QIQ1Fan/haixing/Core/Inc/bsp_config.h

/**
  ******************************************************************************
  * @file    bsp_config.h
  * @brief   ★ 工程总入口：硬件资源分配 + 所有可调参数
  *
  * ============================================================================
  *  一、这个工程是什么
  * ============================================================================
  *  基于 STM32F103C8T6 的八路循迹小车。功能组成：
  *    · 循迹行驶     八路探头 → 位置误差 → 转向环 PID → 左右轮差速
  *    · 闭环测速     双路编码器（可选速度环 / 里程统计 / 状态显示）
  *    · 人机交互     OLED 调参菜单 + 四按键，参数可掉电保存到 Flash
  *    · 支撑脚舵机   舵机推支撑脚，把车撑起 / 收起（自动逻辑留待后续）
  *    · 调试         串口自检菜单 + 实时状态打印
  *
  * ============================================================================
  *  二、外设怎么分（一个外设只干一件事，互不打架）
  * ============================================================================
  *  定时器类：
  *    TIM3  CH1  PA6         左电机 PWM                   20kHz  硬件 PWM
  *    TIM3  CH2  PA7         右电机 PWM                   20kHz  硬件 PWM
  *    TIM2  CH1/2 PA0/PA1    左编码器 A/B 相（硬件四倍频） 不计频
  *    TIM4  CH1/2 PB6/PB7    右编码器 A/B 相（硬件四倍频） 不计频
  *    TIM1  （无输出引脚）    支撑脚舵机软件 PWM 的时基     1MHz   ★ 见下方说明
  *    SysTick                主循环 10ms 节拍 + HAL_Delay
  *
  *  串口类：
  *    USART1     PA9/PA10    调试打印 / 蓝牙模块           115200-8-N-1
  *
  *  纯 GPIO 类：
  *    PB0  PB1     TB6612 AIN1/AIN2   左电机方向
  *    PB10 PB11    TB6612 BIN1/BIN2   右电机方向
  *    PA4          TB6612 STBY        高=工作 低=待机
  *    PB4          支撑脚舵机信号      ★ 软件 PWM，见下方说明
  *    PA2 PA3 PA5 PA8 PA11 PA12 PB5 PB12   八路循迹（内部上拉输入）
  *    PB13 PB14 PB15 PA15                  四按键：确认/退出/加/减
  *    PB3          蜂鸣器（低电平触发）
  *    PB8 PB9      OLED 软件 I2C（SCL/SDA）
  *    PA13 PA14    SWD 调试口（不能动）
  *
  *  ★★ JTAG 引脚释放（PA15 / PB3 / PB4 都靠它）★★
  *    这三个脚默认是 JTAG 的 JTDI / JTDO / NJTRST，不是普通 GPIO。
  *    CubeMX 已在 HAL_MspInit() 里调用 __HAL_AFIO_REMAP_SWJ_NOJTAG()：
  *    它把 SWJ_CFG 设成 010（JTAG-DP 关闭、SW-DP 保留），于是
  *    PA15、PB3、PB4 全部变成普通 GPIO，同时 PA13/PA14 的 SWD 下载不受影响。
  *    删掉那行，本工程就会有三个引脚静默失效（按键的"减"、蜂鸣器、舵机）。
  *
  *  ★★ 为什么舵机是软件 PWM 而不是硬件 PWM ★★
  *    PB4 上唯一可用的定时器输出是 TIM3_CH1（部分重映射）。但 TIM3 已经
  *    被电机 PWM 占用了，而 TIM3 的重映射是"整组生效"的 —— 一旦重映射，
  *    CH1/CH2 会从 PA6/PA7 一起搬到 PB4/PB5，电机就没波形了，而且 PB5
  *    还被循迹占用。TIM1/TIM2/TIM4 的通道都不在 PB4 上。
  *    （TIM3 完全重映射的目标 PC6~PC9 在 LQFP48 封装上没有引出。）
  *
  *    所以改用 TIM1 做纯时基 + 中断里翻转 PB4：每 20ms 两次中断，
  *    合计 100 次/秒，CPU 开销可以忽略。代价是脉冲边沿有几十微秒的
  *    软件抖动，普通舵机会有轻微嗡嗡声。
  *
  * ============================================================================
  *  三、软件分层（谁调用谁）
  * ============================================================================
  *
  *   应用层  app_*        ┌──────────────┐
  *   （小车业务）         │   app_menu   │  OLED 调参界面 + 四按键
  *                        └──────┬───────┘
  *                               │ 改参数 / 启停
  *                               ▼
  *                        ┌──────────────┐   ┌──────────────┐
  *                        │   app_car    │──►│   app_leg    │ 支撑脚舵机
  *                        │  循迹控制律  │   └──────┬───────┘
  *                        └──┬────────┬──┘          │
  *                           │        │             │
  *   驱动层  bsp_*           ▼        ▼             ▼
  *                     ┌─────────┐ ┌────────┐  ┌──────────┐
  *                     │bsp_motor│ │bsp_pid │  │bsp_servo │
  *                     └────┬────┘ └────────┘  └────┬─────┘
  *                          │                       │
  *              ┌───────────┼───────────┬───────────┘
  *              ▼           ▼           ▼
  *        ┌──────────┐ ┌──────────┐ ┌──────────┐
  *        │bsp_track │ │bsp_encod.│ │bsp_gpio  │
  *        └──────────┘ └──────────┘ └────┬─────┘
  *                                       │
  *              ┌────────┬────────┬──────┴───┬──────────┐
  *              ▼        ▼        ▼          ▼          ▼
  *          bsp_key  bsp_oled  bsp_uart  bsp_buzzer  app_param
  *                                                        （Flash 参数）
  *
  *    参数总线：app_param 里的 g_param 是"所有可调参数的唯一存放处"。
  *    app_menu 负责改它，app_car / app_leg 每个控制周期读它 ——
  *    所以调参是"立即生效"的，不需要任何跨模块通知机制。
  *
  * ============================================================================
  *  四、初始化顺序（main.c 里按此顺序调用）
  * ============================================================================
  *   UART → GPIO → Buzzer → Key → Track → Encoder → Servo → Motor → OLED
  *        → Param → Leg → Car → Menu
  *   · UART 最先：后面任何模块出问题，报错才打得出来
  *   · Motor 靠后且 STBY 最后使能：避免上电瞬间电机乱冲
  *   · OLED 靠后：它自带 100ms 上电等待，不拖累前面的模块
  *   · Param 必须在 Leg / Car 之前：它们要读参数决定初始姿态
  *
  * ============================================================================
  *  五、怎么用
  * ============================================================================
  *   1. 硬件对不上时，只改本文件里的宏，别的地方不用动
  *   2. 需要改"默认手感"（PID、速度、丢线策略）时改 app_param.c 的默认值表，
  *      或者直接在 OLED 菜单里调完按"保存"，掉电不丢
  *   3. Keil 编译下载，串口 115200 打开，按 1~9 逐项验硬件
  *   4. 底层全绿后，OLED 菜单选 "START" 就能跑车
  *
  * ============================================================================
  *  六、时钟前提（CubeMX 已配好，这里只是说明为什么下面的公式成立）
  * ============================================================================
  *   HSE 8MHz → PLL×9 → SYSCLK = 72MHz
  *   AHB  = 72MHz
  *   APB1 = 36MHz（HCLK 分频 2）→ 挂在 APB1 上的 TIM2/TIM3/TIM4 时钟 = 72MHz
  *   APB2 = 72MHz                → 挂在 APB2 上的 TIM1 时钟      = 72MHz
  *
  *   ★ 关键点：APB1 分频系数只要不等于 1，STM32 会自动把该总线上
  *     定时器的时钟再乘 2。所以 TIM2/TIM3/TIM4 虽然挂在 36MHz 的 APB1 上，
  *     实际计数时钟仍是 72MHz。算 PWM 频率时要用 72MHz，不是 36MHz。
  ******************************************************************************
  */
#ifndef __BSP_CONFIG_H
#define __BSP_CONFIG_H

#ifdef __cplusplus
extern "C" {
#endif

#include "stm32f1xx_hal.h"

/* ==========================================================================
 * 1. 支撑脚舵机 —— PB4 / 软件 PWM / 50Hz
 * --------------------------------------------------------------------------
 * 数据流： APP_Leg_SetAngle(角度) → BSP_Servo_SetAngle → 换算成脉宽 s_pulse_us
 *            → TIM1 中断每 20ms 翻转两次 PB4
 *              （周期开始拉高，过了脉宽时间拉低）
 *            → 舵机比较脉宽 → 转到对应角度 → 推/收支撑脚
 *
 * 为什么是 50Hz：舵机（航模舵机）的标准控制协议就是每 20ms 收到一个脉冲，
 * 脉冲高电平 0.5~2.5ms 对应左右两个极限位置。频率不对舵机会抖或不响应。
 *
 * ★ 本工程里舵机不用于转向 —— 转向靠左右轮差速（详见第 9 节）。
 *   舵机只负责支撑脚：放下（撑起车身）/ 收起（行驶位）。
 *   具体角度不写死在这里，而是作为可调参数放在 app_param 里，
 *   因为支撑脚的机械行程必须实车标定，菜单里改完能直接存 Flash。
 * ========================================================================== */
#define SERVO_GPIO_PORT             GPIOB
#define SERVO_GPIO_PIN              GPIO_PIN_4

/* 软件 PWM 的时基定时器。★ 它一个输出引脚都不占，只提供"1 微秒走一格"的
   计时和每周期一次的更新中断。所以换成别的定时器也不影响接线。 */
#define SERVO_TIM                   TIM1
/* 72MHz / (71+1) = 1MHz，即 1 个计数 = 1 微秒。
   这样中断里算时间不需要任何换算，读到的计数就是微秒数 */
#define SERVO_TIM_PSC               (72u - 1u)
/* 周期 20000 微秒 = 20ms = 50Hz */
#define SERVO_PWM_PERIOD_US         20000u
/* TIM1 的更新中断优先级。比 SysTick(15) 高，保证脉冲边沿不被主循环拖慢 */
#define SERVO_IRQ_PRIORITY          1u

/* 舵机的机械行程标定。
 * ★ 本工程的舵机规格：500~2500us 对应 0°~180°，中位 90° = 1500us。
 *   如果你的舵机是 1000~2000us 那种小舵机，把下面两个 US 值改掉即可，
 *   角度范围不用动（换算公式会自动按比例适配）。 */
#define SERVO_PULSE_MIN_US          500u    /* 对应 0°   */
#define SERVO_PULSE_MAX_US          2500u   /* 对应 180° */
#define SERVO_PULSE_MID_US          1500u   /* 对应 90°  */
#define SERVO_ANGLE_MIN             0
#define SERVO_ANGLE_MAX             180
#define SERVO_ANGLE_MID             90

/* ==========================================================================
 * 2. 电机 —— TIM3_CH1/CH2 / PA6 / PA7 / 20kHz
 * --------------------------------------------------------------------------
 * 数据流： BSP_Motor_SetSpeed(带符号速度)
 *            ├─ 符号位 → 决定 AIN1/AIN2 电平组合 → TB6612 输出极性
 *            └─ 绝对值 → 写进 CCR → 决定 PWM 占空比 → TB6612 输出电压
 *
 * 为什么是 20kHz：超过人耳听觉上限电机就不发出刺耳啸叫；低于 16kHz
 * 能听到尖锐噪音。20kHz 是"噪音"与"MOS 开关损耗"之间的常用折中。
 * ========================================================================== */
#define MOTOR_TIM                   TIM3
#define MOTOR_CH_L                  TIM_CHANNEL_1   /* PA6 */
#define MOTOR_CH_R                  TIM_CHANNEL_2   /* PA7 */
#define MOTOR_GPIO_PORT             GPIOA
#define MOTOR_GPIO_PIN_L            GPIO_PIN_6
#define MOTOR_GPIO_PIN_R            GPIO_PIN_7

/* PSC=0 → 计数时钟就是 72MHz；ARR=3599 → 72MHz/3600 = 20kHz。
 * 占空比分辨率 = 1/3600 ≈ 0.028%。若图省事取 PSC=71（1MHz 计数），
 * ARR 只剩 999，分辨率掉到 0.1%，低速时能看出明显台阶感。 */
#define MOTOR_TIM_PSC               (0u)
#define MOTOR_TIM_ARR               (3600u - 1u)
#define MOTOR_PWM_MAX               (MOTOR_TIM_ARR)     /* 满占空比对应值 */

/* TB6612 方向引脚 + 使能 */
#define MOTOR_DIR_PORT              GPIOB
#define MOTOR_AIN1_PIN              GPIO_PIN_0
#define MOTOR_AIN2_PIN              GPIO_PIN_1
#define MOTOR_BIN1_PIN              GPIO_PIN_10
#define MOTOR_BIN2_PIN              GPIO_PIN_11
#define MOTOR_STBY_PORT             GPIOA
#define MOTOR_STBY_PIN              GPIO_PIN_4

/* ==========================================================================
 * 电机转向取反 —— 出厂默认值（纠正"电机正负极接反"）
 * --------------------------------------------------------------------------
 * ★ 这两个宏现在只是【默认值】：它们决定 APP_Param 里 MLINV / MRINV 的出厂值，
 *   而真正起作用的是那份参数（见 app_param.c）。所以：
 *     · 在这里改 + 重编 —— 适合"一次定下来，以后不用管"
 *     · 在 OLED 菜单 TUNE PARAMS 里改 MLINV / MRINV —— 适合现场试，
 *       改完立刻生效，不用重编重烧
 *   两条路都通，值不会打架（菜单里改的就是这个默认值的副本）。
 *
 * 【为什么现在是 L=1、R=0】
 *   更换电机之后，由于接线问题，整台车的"前进"变成了"后退" ——
 *   也就是说【两个电机的极性相对之前的配置整体翻了一次】。
 *
 *   要纠正"整体翻一次"，就把这两个开关【同时取反】：
 *       原来 L=0 / R=1   →   现在 L=1 / R=0
 *   ★ 注意是"两个都取反"，不是"两个都写 1"：
 *     两个都写 1 只是在原来的基础上再翻一次，结果是车往后走。
 *   ★ 同时取反之后，不只是前后方向恢复，左右转向也跟着恢复 ——
 *     因为软件取反和硬件接反正好互相抵消，命令到轮子的映射回到了原样。
 *
 * 【怎么复核】
 *   把车架空（轮子离地）敲测试 4，前进段两个轮子都该朝车头方向转。
 *     · 复验通过            → 就这样，不用再动
 *     · 有一个轮子反了       → 只把那一个的开关取反（车会原地打转就是这种）
 *     · 两轮都往后走         → 这次是"两个都写 1"（即两个都再翻一次）
 *
 * 【⚠ 换电机/重新接线之后，除了这两个开关，还要复核 STEERINV】
 *   如果接线时把左右两个电机的位置也对调了，那么"左右分配"也翻了，
 *   STEERINV 要跟着改回 0，否则车会往远离线的方向拐。
 *   判断方法：车放线上、故意让线偏在左边，启动后车应该朝【左】拐。
 *
 * 【它管什么、不管什么】
 *   只管"电机正转的方向对不对"，不管"左右轮有没有装反"。
 *   两个轮子都往前转、也能走直线，但上了线越纠越偏 —— 那是 STEERINV 的事。 */
#define MOTOR_L_INVERT              1
#define MOTOR_R_INVERT              0

/* ==========================================================================
 * 3. 编码器 —— TIM2(PA0/PA1) / TIM4(PB6/PB7)   硬件编码器模式
 * --------------------------------------------------------------------------
 * 数据流： 电机转 → 编码器出 A/B 两相方波 → 定时器硬件四倍频自动计数（不耗 CPU）
 *          → bsp_encoder 每 10ms 读一次计数差
 *            → 按"实际经过的毫秒数"算转速（抗主循环抖动，见第 9 节说明）
 *
 * 为什么用定时器的编码器模式而不是外部中断：四倍频后脉冲频率很高
 * （减速比 30 时每转上千个计数），用中断会吃掉大量 CPU；硬件模式下
 * 计数完全由定时器外设完成，CPU 只负责周期性读一次数值。
 * ========================================================================== */
#define ENC_L_TIM                   TIM2
#define ENC_R_TIM                   TIM4
#define ENC_GPIO_PORT_L             GPIOA
#define ENC_GPIO_PIN_LA             GPIO_PIN_0      /* TIM2_CH1 */
#define ENC_GPIO_PIN_LB             GPIO_PIN_1      /* TIM2_CH2 */
#define ENC_GPIO_PORT_R             GPIOB
#define ENC_GPIO_PIN_RA             GPIO_PIN_6      /* TIM4_CH1 */
#define ENC_GPIO_PIN_RB             GPIO_PIN_7      /* TIM4_CH2 */

/* ★ STM32F103 的 TIM2~TIM5 全是 16 位计数器（只有 F4/F7 的 TIM2/TIM5 是 32 位），
 *   计数到 65535 会回绕。bsp_encoder 用 (int16_t)(now - last) 处理回绕，
 *   前提是单个采样周期内位移不超过 ±32767 个计数。 */
#define ENC_TIM_IS_16BIT            1

/* --- 测速标定：换电机/换编码器/换轮子都要改这里 --- */
#define ENC_PPR                     13.0f   /* 编码器每转脉冲数（单相） */
#define ENC_MULT                    4.0f    /* 四倍频：A/B 两相各上下沿都计数 */
#define ENC_GEAR_RATIO              30.0f   /* 减速箱减速比 */
/* 输出轴（轮子）转一圈的总计数。转速公式的分母就是它 */
#define ENC_CPR                     (ENC_PPR * ENC_MULT * ENC_GEAR_RATIO)

/* 测速采样周期（名义值）。bsp_encoder 内部按 HAL_GetTick() 实测的间隔
 * 换算转速，这个宏只在"实测间隔不合理"时作为兜底值使用 */
#define ENC_SAMPLE_PERIOD_MS        10u

/* 单次采样间隔的合法范围（毫秒）。
 *   下限 1ms：两次调用挤在同一毫秒内时，用 1ms 兜底，杜绝除零。
 *   上限 1000ms：主循环被阻塞超过 1 秒（串口自检、断点、卡死）时，
 *   这一段增量已经不能代表"当前转速"了，直接丢弃，不报假数据。
 *
 * ★ 注意这里不是"必须 10ms"：bsp_encoder 用的是实测间隔，
 *   所以主循环偶尔被 OLED 刷屏拖到 30ms 也不会算错转速。
 *   这正是它和"写死 10ms"的关键区别。 */
#define ENC_DT_MIN_MS               1u
#define ENC_DT_MAX_MS               1000u

/* 编码器输入滤波系数 0..15（0=不滤波）。电机碳刷噪声大，建议 8~12。
 * 出现"高速丢计数"就往下调；出现"轮子没动计数却在跳"就往上调。 */
#define ENC_IC_FILTER               10u

/* 编码器方向反了（比如差速时左右轮读数符号相反）置 1 */
#define ENC_L_INVERT                0
#define ENC_R_INVERT                0

/* 轮子直径（mm），用来把转速换算成线速度 mm/s。
 * 只影响显示和串口打印，不影响控制。用卡尺量含橡胶胎面的外径 */
#define ENC_WHEEL_DIA_MM            65.0f

/* ==========================================================================
 * 4. 八路循迹 —— GPIO 上拉输入
 * --------------------------------------------------------------------------
 * 数据流： 探头 → 电平 → BSP_Track_GetMask() 位掩码
 *          → 加权求和 → BSP_Track_GetError() 位置误差 → 转向环 PID
 *
 * 索引约定：索引 0..7 默认对应对着车头从左到右。装反了不用改接线，
 * 把下面 TRACK_WEIGHT_0..7 这八个值倒过来写即可。
 * ========================================================================== */
#define TRACK_SENSOR_NUM            8u

/* ★ 这里必须用纯宏 1/0，不能写 GPIO_PIN_RESET：
 *   GPIO_PinState 是 enum 而不是 #define，在 #if 预处理里两个标识符
 *   都会被当成未定义、一律替换成 0，导致条件恒真、分支永远进同一边。
 *   bsp_track.c 里就是用 #if TRACK_ACTIVE_LOW 选分支的。 */
/* ★ 探头极性：压到黑线时引脚是高还是低。1 = 低电平（多数模块），0 = 高电平。
 *
 * 【为什么这里是 0 —— 实车实测推翻了默认值】
 *   把车放好、让黑线正对探头阵列中心，SENSOR CHECK 页读到：
 *       RAW  00111100    → 中间 4 路（2,3,4,5）是高电平，两侧各 2 路是低电平
 *       MASK 11000011    → 老配置说"两侧 4 路压线"
 *   一条居中的黑线只可能压住中间连续的一段探头，绝不可能只压住
 *   最左两路 + 最右两路 —— 那是几何上不可能的图形。
 *   所以真正压到线的是中间那 4 路，而它们读的是【高电平】→ 本模块是高电平有效。
 *
 * ★ 这项现在是运行期参数（app_param 的 ACTLOW），这个宏只是它的出厂默认值。
 *   万一以后换了别的探头模块，在菜单里把 ACTLOW 拨一下就能立刻验证，
 *   不用重编 —— 判断标准见 SENSOR CHECK 页：掩码的 1 必须落在真正压线的那几路上。 */
#define TRACK_ACTIVE_LOW            0

#define TRACK0_PORT                 GPIOA
#define TRACK0_PIN                  GPIO_PIN_2      /* PA2  */
#define TRACK1_PORT                 GPIOA
#define TRACK1_PIN                  GPIO_PIN_3      /* PA3  */
#define TRACK2_PORT                 GPIOA
#define TRACK2_PIN                  GPIO_PIN_5      /* PA5  */
#define TRACK3_PORT                 GPIOA
#define TRACK3_PIN                  GPIO_PIN_8      /* PA8  （原来的舵机脚，已改作循迹）*/
#define TRACK4_PORT                 GPIOA
#define TRACK4_PIN                  GPIO_PIN_11     /* PA11 */
#define TRACK5_PORT                 GPIOA
#define TRACK5_PIN                  GPIO_PIN_12     /* PA12 */
#define TRACK6_PORT                 GPIOB
#define TRACK6_PIN                  GPIO_PIN_5      /* PB5  */
#define TRACK7_PORT                 GPIOB
#define TRACK7_PIN                  GPIO_PIN_12     /* PB12 */

/* 加权位置误差的权重表，索引 0..7 对应传感器 0..7。
 * 计算方式：误差 = Σ(权重 × 该路是否压线) / 压线个数，量程 [-7.0, +7.0]
 *    误差 < 0 → 线在车的左边（车偏右了）→ 需要左转
 *    误差 > 0 → 线在车的右边（车偏左了）→ 需要右转
 *
 * 注意：8 是偶数，探头阵列没有物理中点，所以车正对线时误差会在 ±1
 * 之间跳动而不是稳定的 0，这是正常的，不用去"修"。 */
#define TRACK_WEIGHT_0              (-7.0f)
#define TRACK_WEIGHT_1              (-5.0f)
#define TRACK_WEIGHT_2              (-3.0f)
#define TRACK_WEIGHT_3              (-1.0f)
#define TRACK_WEIGHT_4              ( 1.0f)
#define TRACK_WEIGHT_5              ( 3.0f)
#define TRACK_WEIGHT_6              ( 5.0f)
#define TRACK_WEIGHT_7              ( 7.0f)
/* 误差绝对值上限，用于把误差归一化到 [-1,1] 喂给 PID。
 * 必须等于权重表里绝对值最大的那个，否则归一化会超出 ±1 */
#define TRACK_ERROR_MAX             (7.0f)

/* ==========================================================================
 * 5. 四路按键 —— GPIO 上拉输入，按下读低
 * --------------------------------------------------------------------------
 * 数据流： 引脚电平 → BSP_Key_Scan() 每 10ms 消抖一次
 *          → 短按/长按/连发事件 → app_menu 读走
 *
 * ★ 按键的四个键在本工程里各有一个固定角色（OLED 菜单里印在屏幕底部）：
 *     确认 PB13   进入 / 执行 / 结束编辑
 *     退出 PB14   返回上一级 / 运行中按下 = 急停
 *     加   PB15   选中项上移 / 参数 +
 *     减   PA15   选中项下移 / 参数 -
 * ========================================================================== */
#define KEY_NUM                     4u
/* 按下时的电平。上拉输入 → 按下是低电平。这里只在运行期做比较，用枚举没问题 */
#define KEY_ACTIVE_LEVEL            GPIO_PIN_RESET

/* 四个键的物理位置与固定角色（★ 换引脚只改这四组宏，其它代码一行都不用动）
 *
 *   按键1  PB13   确认 / 进入 / 选定         角色名 KEY_OK
 *   按键2  PB14   取消 / 返回上一级           角色名 KEY_BACK
 *   按键3  PB15   上移（列表）· 加（数值）    角色名 KEY_PLUS
 *   按键4  PA15   下移（列表）· 减（数值）    角色名 KEY_MINUS
 *
 * ★ 代码里全程用 KEY_OK / KEY_BACK / KEY_PLUS / KEY_MINUS 这四个"角色"，
 *   而不是引脚号。所以按键挪到别的脚上时，菜单逻辑一行都不用改 ——
 *   只要保证"物理上那个'加'键"接到 KEY_PLUS 对应的引脚即可。
 *
 * ★ 按键另一端统一接 GND，靠内部上拉，按下读到低电平（见 KEY_ACTIVE_LEVEL）。*/
#define KEY_OK_PORT                 GPIOB
#define KEY_OK_PIN                  GPIO_PIN_13     /* 按键1 确认 */
#define KEY_BACK_PORT               GPIOB
#define KEY_BACK_PIN                GPIO_PIN_14     /* 按键2 取消 */
#define KEY_PLUS_PORT               GPIOB
#define KEY_PLUS_PIN                GPIO_PIN_15     /* 按键3 上移 / 加 */
#define KEY_MINUS_PORT              GPIOA
#define KEY_MINUS_PIN               GPIO_PIN_15     /* 按键4 下移 / 减 */

/* 消抖与长按的时间参数，单位都是"扫描次数"，一次扫描 = KEY_SCAN_PERIOD_MS */
#define KEY_SCAN_PERIOD_MS          10u
#define KEY_DEBOUNCE_CNT            3u      /* 连续 3 次读数一致才认可 = 30ms 消抖 */
#define KEY_LONG_PRESS_CNT          60u     /* 60 × 10ms = 按住 0.6 秒算长按 */
#define KEY_REPEAT_CNT              8u      /* 长按后每 8 × 10ms = 80ms 连发一次 */

/* ==========================================================================
 * 6. 蜂鸣器 —— PB3 / 推挽输出 / 低电平触发
 * --------------------------------------------------------------------------
 * 数据流： BSP_Buzzer_On/Off → PB3 电平 → 蜂鸣器响或不响
 *
 * ★ PB3 是 JTAG 的 JTDO，靠 HAL_MspInit() 里的 SWJ_NOJTAG 释放。
 * ★ 跑车过程中只能用 BeepAsync() + Poll()，绝不能用阻塞的 Beep()：
 *   阻塞 100ms 就等于漏掉 10 拍控制，车会画龙。
 * ========================================================================== */
#define BUZZER_PORT                 GPIOB
#define BUZZER_PIN                  GPIO_PIN_3
/* 低电平触发：响 = RESET，静音 = SET。
 * 如果你的蜂鸣器模块是高电平触发，把这两个值对调即可。 */
#define BUZZER_ON_LEVEL             GPIO_PIN_RESET
#define BUZZER_OFF_LEVEL            GPIO_PIN_SET

/* ==========================================================================
 * 7. OLED —— 软件 I2C / PB8=SCL / PB9=SDA
 * --------------------------------------------------------------------------
 * 数据流： 绘制函数 → 改 1KB 显存 s_buf[] 并标记"这一页脏了"
 *          → BSP_OLED_RefreshDirty() → 只把脏页通过软件 I2C 送出去
 *
 * ★ 为什么要"脏页"机制：
 *   整屏 1024 字节走软件 I2C 大约要 40~50ms，如果每 10ms 就整屏刷一次，
 *   主循环会被吃掉一半，控制节拍全乱。改成"只刷变化的那几页"之后，
 *   状态页一次只送 2~3 页（约 10ms），影响小得多。
 *   BSP_OLED_Refresh()（整屏）仍然保留，开机画面和自检图案用它。
 *
 * ★ 软件 I2C 慢的根因是 i2c_delay() 里的空循环，想更快就调小
 *   OLED_I2C_DELAY_LOOPS。默认 20 很保守（约 100kHz），
 *   调到 5 左右大约能快三倍，代价是长排线时容易花屏。
 * ========================================================================== */
#define OLED_SCL_PORT               GPIOB
#define OLED_SCL_PIN                GPIO_PIN_8
#define OLED_SDA_PORT               GPIOB
#define OLED_SDA_PIN                GPIO_PIN_9
/* SSD1306 的 8 位写地址（7 位地址 0x3C 左移一位）。
 * 如果屏幕全黑但接线没问题，试试改成 0x7A（7 位 0x3D）。 */
#define OLED_I2C_ADDR               0x78u
#define OLED_WIDTH                  128u
#define OLED_HEIGHT                 64u
/* 软件 I2C 的半周期延时（空循环次数）。
 * 屏幕花屏 / 无显示 / 偶发乱码时调这个值：太小则时序过快，太大则刷屏卡顿。 */
#define OLED_I2C_DELAY_LOOPS        20u

/* ==========================================================================
 * 8. 串口调试 —— USART1 / PA9(TX) / PA10(RX) / 115200
 * --------------------------------------------------------------------------
 * 数据流： BSP_UART_Printf() → vsnprintf 格式化 → HAL_UART_Transmit 阻塞发送
 *          接收方向：主循环轮询 BSP_UART_GetChar()，不占用中断
 * ★ 跑车时不要高频打印：115200 下发 1 行 40 字符要 3.5ms，
 *   每拍都打就等于每 10ms 停 3.5ms。bsp_test 里的实时打印都带节流。
 * ========================================================================== */
#define DBG_UART                    USART1
#define DBG_UART_BAUD               115200u
#define DBG_UART_TX_PORT            GPIOA
#define DBG_UART_TX_PIN             GPIO_PIN_9
#define DBG_UART_RX_PORT            GPIOA
#define DBG_UART_RX_PIN             GPIO_PIN_10
/* printf 缓冲区大小。注意它分配在栈上，别超过主栈（CubeMX 配的 0x400 = 1KB） */
#define DBG_PRINTF_BUF_SIZE         128u

/* 是否把 fputc 重定向到串口，让标准 printf() 直接可用。
 *   0 = 默认。只用 BSP_UART_Printf()。功能与 printf 等价，不依赖工具链特性，
 *       不屏蔽半主机（Event Recorder / ITM 仍可用），保证一定能编过。
 *   1 = 额外把 fputc 重定向到 USART1，之后可以直接写 printf()。
 *       代价：屏蔽半主机调试。若链接报 _sys_exit / __use_no_semihosting
 *       相关错误，把它改回 0 即可，BSP_UART_Printf() 不受影响。 */
#define BSP_UART_USE_PRINTF_RETARGET    0

/* ==========================================================================
 * 9. 控制节拍与循迹控制 —— ★ 全工程的时间基准
 * --------------------------------------------------------------------------
 * main.c 里只有一个软节拍器，所有周期性任务都挂在它上面：
 *
 *   每 MAIN_TICK_MS 一次：
 *     BSP_Encoder_Update()   采样编码器（按实测 dt 换算转速）
 *     BSP_Key_Scan()         推进按键状态机
 *     BSP_Buzzer_Poll()      关掉到点的非阻塞鸣叫
 *     APP_Car_Update()       跑一遍循迹控制律（核心）
 *     APP_Leg_Update()       支撑脚缓慢移动
 *     APP_Menu_Update()      按键处理 + 屏幕刷新
 *
 * ★ 下面这四个周期宏必须完全相等，否则转速会成比例偏、按键时间阈值会失准。
 *   与其靠人记住，不如让编译器替我们盯着 —— 不相等直接报错。
 * ========================================================================== */
#define MAIN_TICK_MS                10u     /* 主循环节拍 */
#define CTRL_PERIOD_MS              10u     /* 循迹控制周期 = 控制环的 100Hz */

#if ((MAIN_TICK_MS != CTRL_PERIOD_MS) || \
     (MAIN_TICK_MS != ENC_SAMPLE_PERIOD_MS) || \
     (MAIN_TICK_MS != KEY_SCAN_PERIOD_MS))
#error "MAIN_TICK_MS / CTRL_PERIOD_MS / ENC_SAMPLE_PERIOD_MS / KEY_SCAN_PERIOD_MS 必须全部相等"
#endif

/* 转向环 PID 的采样周期（秒）。喂给 PID 做积分/微分用，必须等于 CTRL_PERIOD_MS */
#define CTRL_DT_S                   ((float)CTRL_PERIOD_MS / 1000.0f)

/* PID 微分项的一阶低通系数（0~1，越小越平滑）。
 * ★ 循迹误差是"8 路开关量加权平均"出来的，天生是阶梯状的，
 *   直接微分会得到一串尖脉冲。加低通之后 D 项才真正可用 */
#define PID_D_FILTER_ALPHA          0.35f

/* ★★ 微分项的限幅比例：D 项单独最多能占输出的百分之多少 ★★
 *
 * 【为什么必须有这一条（这是"边缘探头一读到就往反方向猛打"的直接原因）】
 *   D 项 = KD × (误差变化率)。而误差变化率 = 误差变化量 ÷ 采样周期，
 *   采样周期只有 10ms，所以只要误差跳一格（0.14），变化率就是 14/秒。
 *
 *   探头阵列窄的时候，线扫过阵列只要几十毫秒，误差会从 -1 瞬间跳到 +1：
 *       变化率 = 2.0 / 0.01 = 200/秒
 *       D 项 = KD × 200 = 180 × 200 = 36000
 *   而输出的满量程才 3600 —— D 项早就爆表了，只是被总限幅按住而已。
 *   结果是：**转向输出被 D 项一个人顶到限幅**，P 项完全不起作用，
 *   控制器退化成"一看见误差跳变就往反方向打死"，看起来就是
 *   "边缘探头一读到线，车立刻往反方向甩过去"。
 *
 *   限幅之后 D 项只能贡献一半的输出，剩下的由 P 项决定 ——
 *   D 重新变回"阻尼器"的身份（抑制摆动），而不是"抢方向盘的乘客"。
 *   上限 50% 是经验值：再高就会重新出现甩头，再低则起不到阻尼作用。 */
#define PID_D_LIMIT_RATIO           0.5f

/* 运行中 OLED 的刷新周期。刷屏期间主循环会停住十几毫秒，
 * 所以跑车时不能刷太勤；200ms 一次足够看清数值 */
#define MENU_RUN_REFRESH_MS         200u

/* 停车/待机时 OLED 的刷新周期。调参时人要看着数字变化，快一点 */
#define MENU_IDLE_REFRESH_MS        120u

/* 编码器在本工程里的用途 —— 不做速度闭环，只做"安全与计量"。
 *
 * ★ 为什么不做速度闭环：
 *   循迹环的输出是"左右轮的占空比之差"，它管的是转向；速度闭环管的是
 *   "轮子转多快"。两者串起来要先把占空比标定成转速（每个车都不一样），
 *   参数多一倍、整定难度翻几倍，而在这个速度下收益很小。
 *   所以本工程让编码器干两件立刻见效的事：
 *
 *     1) 堵转检测：占空比给得不小，轮子却一个计数都不动
 *        → 车卡住了 / 编码器线掉了 → 报警停车，保护减速箱
 *     2) 状态显示：OLED 上显示左右轮的实时转速和累计里程
 *
 *   以后真要上速度闭环，把转向环的输出接到一个速度环的目标值上即可，
 *   bsp_pid 是通用的，不用改。
 */
#define CAR_STALL_DUTY_MIN          700     /* 占空比低于这个值就不做堵转判断（起步/低速正常不动） */
#define CAR_STALL_DETECT_MS         1200u   /* 连续这么多毫秒"给电但不转"就报警 */


/* 路线脚本里"数横线"的最小间隔（毫秒）。
 * Route_LineFollowUntilCross(n) 靠"八路全黑"来数路口的横线，
 * 但同一根横线在车压过去的过程中可能黑好几次，所以两根之间至少隔这么久
 * 才算新的一根。太小会把一根数成好几根，太大又会漏掉挨得近的路口 */
#define CAR_CROSS_MIN_GAP_MS        250u

/* 路标（探头图案）需要连续保持多久才算"真的看到了"（毫秒）。
 * Route_LineFollowUntilMark() 用它做去抖：过线的瞬间、探头噪声、
 * 或者车体一晃，都可能让某几路短暂同时压线；要求图案保持 60ms
 * 才认，基本能滤掉这些假信号，而真路标会保持几十厘米、远超这个时间 */
#define CAR_MARK_HOLD_MS            60u

/* ---- 循线段的"地形自动穿越"阈值 ----
 * 实测：本赛道的地形（石块/草地/减速带）虽然盖住了黑线，但中断很短 ——
 * 普通循迹就能开过去，说明"全白"持续不到 60ms（app_car 的丢线判据）。
 * 既然如此，就不需要为它们写特殊的盲走段。
 * 但为了"万一遇到更长的无线段"，循线原语里加了两条兜底：
 *   全白超过 CAR_TERRAIN_ENTER_MS  → 认为压上地形了，这一段改成直行盲走
 *   （不这么做的话，app_car 的丢线逻辑会朝一边猛转，车在地形上打转）
 *   盲走超过 CAR_TERRAIN_MAX_MS 还看不到线 → 认为真的丢了，
 *   交回正常的丢线逻辑去转向搜索（不然会一直直着冲出去）
 * ★ 正常情况（线中断很短）这两条都不会触发，行为和以前完全一样。 */
#define CAR_TERRAIN_ENTER_MS        40u     /* 必须 < app_car 的丢线去抖(60ms) */
#define CAR_TERRAIN_MAX_MS          1500u   /* 盲走多久还没线就交回丢线搜索 */

/* ---- 丢线事件计数器（"全丢黑线的次数"）的"重新武装"时间 ----
 * 计数器算的是"探头完全看不到黑线"发生了几次，规则：
 *     由"有线"变成"全白" → 计数 +1
 *     必须重新连续看到线超过这么久，才允许下一次 +1
 * 为什么要它：草地和减速带可能是【两块挨着的地形】，中间只有一小段线。
 * 没有重新武装时间的话，那一小段线会让计数再 +1，
 * 于是"第几次丢线"就对不上"第几个地形"了。
 * 定在 500ms：中间有线超过半秒，才算真的穿过了一块地形。 */
#define CAR_LOST_REARM_MS           500u

/* ==========================================================================
 * 10. 支撑脚舵机 —— 行程与运动参数
 * --------------------------------------------------------------------------
 * 数据流： APP_Leg_Down() → 目标角度进 app_param.leg_down_deg
 *          → APP_Leg_Update() 每 10ms 走一小步 → BSP_Servo_SetAngle()
 *
 * ★ 为什么要"走小步"而不是一步到位：
 *   支撑脚是刚性机构，直接跳变会让舵机瞬间满速冲击，齿轮容易打坏、
 *   车也会被顶得跳一下。分成每 10ms 走 1~3 度，1 秒内走完全程，
 *   既温柔又看不出慢。
 *
 * ★ 具体角度（leg_up_deg / leg_down_deg）是可调参数，在 app_param.c 里，
 *   菜单里能改、能存 Flash —— 因为支撑脚的机械行程必须实车标定。
 *
 * ★ 本阶段只做"手动放下/收起"（菜单里选、串口命令控制）。
 *   后续要做的"行驶中自动收放"留了钩子，见 app_leg.h 的说明。
 * ========================================================================== */
#define LEG_MOVE_STEP_DEG           2u      /* 每 10ms 移动的最大角度 */
#define LEG_SAFE_MIN_DEG            0u      /* 机械安全下限，再往这边会顶死 */
#define LEG_SAFE_MAX_DEG            180u    /* 机械安全上限 */
#define LEG_SETTLE_MS               600u    /* 到达目标后等多久算"到位" */

/* ==========================================================================
 * 11. 参数掉电保存 —— 用 Flash 最后一页
 * --------------------------------------------------------------------------
 * STM32F103C8T6 的 Flash 是 64KB，页大小 1KB：
 *     0x08000000 ~ 0x0800FFFF   共 64 页
 *     最后一页 0x0800FC00 专门用来存参数
 *
 * ★★ 危险提醒 ★★
 *   这个地址必须保证"程序本身没用到"。本工程编译后大约 20~30KB，
 *   离 63KB 还远得很，安全。但如果哪天工程膨胀到接近 64KB，
 *   或者改了链接脚本，就必须把这个宏挪到别的页（同时改 Keil 的
 *   IROM 范围），否则"保存参数"会把程序代码擦掉 —— 现象是
 *   按下保存后单片机变砖，只能重新下载。
 *   保险做法：每次大改之后看一眼 Keil 编译输出的 Program Size，
 *   确认 Code+RO-data 没有接近 0xFC00。
 *
 * ★ 掉电保存是可关的：把 PARAM_FLASH_ENABLE 改成 0，
 *   参数就只存在 RAM 里，上电永远是默认值。调参阶段不怕写坏 Flash。
 * ========================================================================== */
#define PARAM_FLASH_ENABLE          1
#define PARAM_FLASH_PAGE_ADDR       0x0800FC00u
#define PARAM_FLASH_PAGE_SIZE       1024u
#define PARAM_MAGIC                 0x48414958u  /* 'HAIX' 参数区有效标志 */

/* ★ 参数结构体一改（加字段、删字段、换顺序），这个版本号必须 +1。
 *   校验和只能挡住"位翻转"，挡不住"按新布局去读老数据"——
 *   版本号才是那道闸：对不上就整份丢弃、回到出厂默认值。
 *   历史 1 = 初版
 *        2 = 增加 MLINV / MRINV（电机转向取反）
 *        3 = 增加 SLOWK（大偏差自动减速）
 *        4 = 增加 EDGEN / PIVOT / PIVOTms（转角检测 + 到位急转）
 *        5 = 增加 ACTLOW（探头极性改成运行期可调，默认值按实车实测改为高电平有效）
 *        6 = 删掉 EDGEN / PIVOTms（转角模式已舍弃，回到连续 PID 循迹）
 *        7 = 增加 LF1/TN1/LF2/TN2/LF3/TN3（路线各段时长做成可调参数）
 *        8 = 增加 LF4_ms（上台阶段）
 *        9 = 增加 CROSS_ms（穿地形的时间上限）+ 丢线事件计数 */
#define PARAM_VERSION               9u

#ifdef __cplusplus
}
#endif

#endif /* __BSP_CONFIG_H */
