QIQ1Fan/haixing/Core/Inc/app_route.h

/**
  ******************************************************************************
  * @file    app_route.h
  * @brief   ★ 路线脚本与动作原语（固定地图专用）
  *
  * 【思路】
  *   地图固定 ⇒ 不需要"看见什么再决定"，直接把整条路线写成一段顺序执行的
  *   脚本，每一步调用一个动作原语：
  *
  *       Route_LineFollow(3000);     // 循线走 3 秒
  *       Route_TurnLeft(600);        // 原地左转 0.6 秒
  *       Route_Straight(800);        // 直行 0.8 秒
  *       Route_Servo(180);           // 支撑脚放到 180°
  *       ...
  *
  *   脚本写在 app_route.c 的 APP_Route_Run() 里，改路线只改那一个函数。
  *
  * 【为什么这里的函数是"阻塞"的，却不会把系统卡死】
  *   每个原语内部都有一个小循环（等时间到），循环里会照常做
  *   10ms 控制节拍该做的事：编码器采样、按键扫描、蜂鸣器轮询、支撑脚斜坡。
  *   所以：
  *     · 脚本可以写成一行一行的顺序调用，最好读、最好改
  *     · 期间屏幕照样刷新、按键照样响应
  *     · 长按 K2 随时可以急停并中止整条路线
  *   代价是"路线运行期间主菜单不响应"—— 这是有意的：正在跑路线时，
  *   你不希望有人（或误触）从菜单里插一脚。
  *
  * 【速度用哪些参数】
  *   直行速度  = BASESPD
  *   转弯速度  = PIVOT
  *   循线速度  = BASESPD
  *   都是菜单里已经能调的参数，不再额外加旋钮。
  *
  * 【左右方向的约定】
  *   和循迹、转角模式共用同一套：STEERINV=1 时整车的左右整体对调。
  *   所以装配问题只需要改一个开关，脚本里的 Route_TurnLeft() 永远是"往左"。
  * ============================================================================
  */
#ifndef __APP_ROUTE_H
#define __APP_ROUTE_H

#ifdef __cplusplus
extern "C" {
#endif

#include "bsp_config.h"

/* ==========================================================================
 * 入口
 * ========================================================================== */

/**
  * @brief  在屏幕上问一句"要不要跑路线"：K1 = 开始，K2 = 进菜单
  * @note   一般由 main.c 在初始化完成后调用一次。
  *         选 K2 就直接返回，后面照常进主循环（调参模式）
  */
void APP_Route_Enter(void);

/**
  * @brief  执行整条路线脚本（阻塞，直到脚本跑完或被 K2 长按中止）
  * @note   脚本内容在 app_route.c 的 APP_Route_Run() 里
  */
void APP_Route_Run(void);

/** @brief 是否正在跑路线 */
uint8_t APP_Route_IsActive(void);

/**
  * @brief  请求中止路线（急停）
  * @note   长按 K2 会自动调用它；脚本里的每个原语都会立刻返回，
  *         所以整条脚本会在几十毫秒内"空转"跑完并停车
  */
void APP_Route_Abort(void);

/* ==========================================================================
 * 动作原语 —— 在脚本里按顺序调用
 * ========================================================================== */

/**
  * @brief  循线 ms 毫秒（用中间那几路做 PID，和菜单里的 START CAR 是同一套）
  * @note   到时间会自动停车。想一直循线就传一个大一点的数
  */
void Route_LineFollow(uint16_t ms);

/**
  * @brief  循线，直到经过 n 个"十字/停止线"（八路全黑）后停下
  * @param  n 需要经过的横线根数
  * @note   ★ 固定地图里最好用的一段式原语：
  *         路线上的横线（路口、停止线）就是天然的"路标"，
  *         用"经过几根横线"来切分路段，比用时间可靠得多
  */
void Route_LineFollowUntilCross(uint8_t n);

/* ==========================================================================
 * ★★ 路标触发式路段（抗电压波动）★★
 * --------------------------------------------------------------------------
 *   为什么要有它：用"循线 N 毫秒"来切分路段时，电池一掉电压车速就慢，
 *   同样的时间走过的距离变短，车会在还没到转角时就进入下一段 ——
 *   于是每次电量不同都要重新标定一遍时间，非常难受。
 *
 *   路标触发把"什么时候算走完"从【时间】换成【看到什么】：
 *   赛道上每个转角、路口、停止线在探头阵列上都有固定图案，
 *   看见图案才进下一步 —— 快也好慢也好，位置永远对得上。
 * ========================================================================== */

/* 常用路标：位为 1 = "这一路必须压线"。没写到的位一律不关心 */
#define ROUTE_MARK_CROSS    0xFFu   /* 八路全压：十字路口 / 停止线 */
#define ROUTE_MARK_LEFT     0x03u   /* 最左两路压线：左弯（也用于标定"到左弯了"）*/
#define ROUTE_MARK_RIGHT    0xC0u   /* 最右两路压线：右弯 */
#define ROUTE_MARK_L1       0x01u   /* 只要求最左一路 */
#define ROUTE_MARK_R1       0x80u   /* 只要求最右一路 */

/**
  * @brief  ★ 循线，直到出现指定的探头图案（路标），然后停车
  * @param  on_mask    必须【同时压线】的那几路（ROUTE_MARK_xxx 或自己算的掩码）
  * @param  timeout_ms 兜底超时：这么久还没看到路标就放弃、继续往下走。
  *                    ★ 它是"安全网"不是"计时器"：正常应该由路标触发。
  *                    建议给正常工作时间的 2~3 倍（比如原本约 10 秒就给 25000），
  *                    这样即使电池快没电、车速慢一半，也依然由路标收尾。
  * @note   路标需要【连续保持】CAR_MARK_HOLD_MS（默认 60ms）才算数，
  *         防止过线瞬间或噪声误触发。找到时鸣一声、超时时鸣一声长音，
  *         跑的时候凭声音就能分辨"正常进下一段"还是"没找到路标"。
  *
  *   用法示例（把原来按时间的循线段换掉）：
  *       // 原来： Route_LineFollow(10500u);          // 10.5 秒 —— 掉电压就不准
  *       // 现在：
  *       Route_LineFollowUntilMark(ROUTE_MARK_CROSS, 25000u);
  *       Route_TurnLeft(g_param.rt_tn1_ms);
  */
void Route_LineFollowUntilMark(uint8_t on_mask, uint16_t timeout_ms);

/**
  * @brief  ★★ 盲走（不循线）直到探头重新看到线 —— 穿越地形专用 ★★
  * @param  speed      两轮速度（带符号，正 = 前进）。传 0 = 用参数 BASESPD
  * @param  on_mask    什么图案算"重新看到线了"：
  *                     传 0 = 任意一路压线就算（最常用）
  *                     也可以传 ROUTE_MARK_xxx 要求看到特定图案才停
  * @param  timeout_ms 兜底超时：这么久还没找到线就停下、继续往下走
  *
  * 【为什么必须有这个原语 —— 你的赛道是这种结构】
  *   赛道上的地形（石块 / 减速带 / 搓衣板 / 台阶）都是【平铺在地图上的板子】，
  *   它们盖住了下面的黑线。于是：
  *
  *       循线段（有黑线）→ 地形段（黑线被盖住，探头全白）→ 循线段（线又出现）
  *
  *   地形那一段【不能循线】：探头全白会被判成"丢线"，
  *   而丢线逻辑是"朝最后看到线的方向猛转"—— 车会在地形上原地打转 ✗
  *   所以地形段必须改用"盲走"：两轮同速直行，什么都不看。
  *
  *   ★ 用"重新看到线"来收尾（而不是"走 N 毫秒"）是关键：
  *     电池快没电、车速慢一半时，盲走的时间就要翻倍 ——
  *     用时间收尾的车会停在半路；用"看到线"收尾的车永远停在对的位置 ✓
  *
  *   用法：
  *       Route_LineFollowUntilMark(ROUTE_MARK_CROSS, 25000u);  // 循线到路口
  *       Route_DriveUntilLine(0, 0u, 8000u);                   // 盲走穿过地形
  *       Route_LineFollowUntilMark(ROUTE_MARK_CROSS, 25000u);  // 出来继续循线
  */
void Route_DriveUntilLine(int16_t speed, uint8_t on_mask, uint16_t timeout_ms);

/**
  * @brief  ★★ 循线，直到"全丢黑线"发生第 n 次 —— 用计数当地形编号 ★★
  * @param  n          等到第几次全丢线（从 APP_Car_ResetLostCount() 之后算起）
  * @param  timeout_ms 兜底超时：这么久还没等到就放弃、继续往下走
  *
  * 【为什么这样切路段最合适】
  *   赛道上的地形（石块 / 草地 / 减速带 / 台阶）都是平铺上去的板子，
  *   会把下面的黑线盖住 —— 每经过一块地形，就必然产生一次【全丢线】。
  *   地形在固定赛道上的先后顺序是已知的，于是：
  *
  *       第 1 次全丢线 = 到了第 1 个地形
  *       第 2 次全丢线 = 到了第 2 个地形   ...
  *
  *   路段就用"第几次丢线"来切分：全程都处在循迹状态，
  *   只是在特定编号处换一种跑法去过障碍。
  *
  *   ★ 和时间无关（电池掉电压也不影响判断），也不需要预先量图案。
  *
  *   用法：
  *       APP_Car_ResetLostCount();                    // 路线开头清一次
  *       Route_LineFollowUntilLostCount(1u, 40000u);  // 循线到第 1 个地形
  *       Route_DriveUntilLine(0, 0u, 8000u);          // 换个方式过它
  *       Route_LineFollowUntilLostCount(2u, 40000u);  // 接着循线到第 2 个地形
  *
  * @note   ★ 本函数【不停车】：等到的那一刻车正压在地形上，
  *         紧接着就要用特殊方式开过去，停一下反而会让车在地形边缘顿住。
  */
void Route_LineFollowUntilLostCount(uint8_t n, uint16_t timeout_ms);

/** @brief 两轮同速直行 ms 毫秒（速度 = BASESPD） */
void Route_Straight(uint16_t ms);

/**
  * @brief  原地左转 ms 毫秒
  * @note   履带车靠两边反向搓地：左履带倒转、右履带正转。
  *         转多少度靠时间标定（跑一次量角度，再按比例改时间）
  */
void Route_TurnLeft(uint16_t ms);

/** @brief 原地右转 ms 毫秒 */
void Route_TurnRight(uint16_t ms);

/**
  * @brief  ★ 支撑脚（舵机）缓慢转到 deg 度，并等它到位
  * @param  deg 0~180。0 = 全收起，180 = 全放下（具体含义看机械装法）
  * @note   走的是 app_leg 的角度斜坡（每 10ms 走 2°），不会猛地顶一下
  */
void Route_Servo(uint8_t deg);

/** @brief 支撑脚立刻到位（不走斜坡）。标定时用，机构脆的话慎用 */
void Route_ServoNow(uint8_t deg);

/**
  * @brief  ★ 预约一次舵机动作："after_ms 毫秒之后把支撑脚移到 deg 度"
  * @param  deg      目标角度 0~180
  * @param  after_ms 从现在起多少毫秒后执行
  *
  * 【为什么需要它 —— 让舵机和循线"同时进行"】
  *   脚本是顺序执行的，一行不跑完不会跑下一行。可是上台阶时，
  *   车必须【一边循线往前走】【一边让支撑脚摆动】——
  *   这两件事在时间上是重叠的，顺序写法表达不出来。
  *
  *   于是把舵机动作"预约"出去：调用它只花几微秒就返回，
  *   真正的动作交给后台节拍按时间点执行。这样写：
  *
  *       Route_ServoAt(180u,    0u);   // 立刻放下
  *       Route_ServoAt(0u,   2000u);   // 2 秒后升起
  *       Route_ServoAt(180u, 3000u);   // 再 1 秒后放下
  *       Route_LineFollow(5000u);      // ★ 这 5 秒车一直在循线，
  *                                     //   舵机在后台按上面的点摆动
  *
  *   注意角度是走 app_leg 的斜坡（每 10ms 走 2°，180° 约 0.9 秒走完），
  *   所以两次预约之间留够 1 秒以上，动作才会走完整；
  *   留得少就是"摆到一半又折回去"，正是摆动的效果。
  */
void Route_ServoAt(uint8_t deg, uint16_t after_ms);

/** @brief 停车并等待 ms 毫秒（滑行停） */
void Route_Stop(uint16_t ms);

/** @brief 刹车急停（绕组短接，最快停住） */
void Route_Brake(void);

/** @brief 鸣叫 ms 毫秒（阻塞式，用于分段提示、判断程序走到哪一步了） */
void Route_Beep(uint16_t ms);

/**
  * @brief  ★ 阶段标记：鸣两声（非阻塞）
  * @note   路线里"每过一个阶段"报一下，跑的时候凭声音就知道走到第几步了。
  *         ★ 非阻塞：请求之后立刻返回，两声由后台节拍依次响完 ——
  *         所以它**不会让车在阶段之间停顿**，下一段立刻就开始。
  */
void Route_Beep2(void);

/**
  * @brief  ★ 左右方向自检：原地左转 1 秒 → 停 → 原地右转 1 秒
  * @note   串口命令 T 调用。用来一次性确认"左"到底是哪边 ——
  *         它走的是和路线脚本完全相同的 Route_TurnLeft/Right，
  *         所以这里看到的方向，就是路线里那三步会走的方向。
  *         如果标着左转的却往右走，就是 STEERINV 反了。
  */
void APP_Route_TestTurn(void);

#ifdef __cplusplus
}
#endif

#endif /* __APP_ROUTE_H */
