QIQ1Fan/haixing/logic.ino

void logic() {
  track_zhixian1();
  line_Read();
// if ((D1 != 0) && (D2 != 0) && (D3 != 0) && (D4 != 0) && (Z == 0))  //石块地形
//   { 
//     go(); 
//     delay(4500);
//     Z = 1;
//   } else if ((D1 != 0) && (D2 != 0) && (D7 != 0) && (D8 != 0) && (Z == 1))  //左转
//   {
//     Z = 2;
//     go();
//     delay(500);
//     turn_left();
//     delay(1000);
//   } else if ((D1 != 0) && (D4 != 0) && (D5 != 0) && (D8 != 0) && (Z == 2))  //草坪
//   {
//     Z = 3;
//     // go();
//     run(1, 110, 100);
//     delay(3700);
//   } else if ((D1 != 0) && (D4 != 0) && (D5 != 0) && (D8 != 0) && (Z == 3))  //十字路口
//   {
//     Z = 4;
//     delay(200);
//   } else if ((D1 != 0) && (D4 != 0) && (D5 != 0) && (D8 != 0) && (Z == 4))  //减速带
//   {
//     Z = 5;
//     go();
//     delay(3500);
//   } else if ((D1 != 0) && (D2 != 0) && (D7 != 0) && (D8 != 0) && (Z == 5))  //右转
//   {
//     Z = 6;
//     // run(1, 90, 120);
//     go();
//     delay(500);
//     // run(4, 90, 150);
//     turn_right();
//     delay(800);
//   } else if ((D4 != 0) && (D5 != 0) && (D7 != 0) && (D8 != 0) && (Z == 6))  //右转
//   {
//     Z = 7;
//     // run(1, 90, 120);
//     go();
//     delay(500);
//     // run(4, 90, 150);
//     turn_right();
//     delay(1000);
//   } else if ((D4 != 0) && (D5 != 0) && ((D7 != 0) || (D8 != 0)) && (Z == 7))  //石块
//   {
//     Z = 8;
//     // run(1, 90, 120);
//     go();
//     delay(600);
//     lunzi.write(120);
//     // run(1, 90, 120);
//     go();
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
//     delay(1500);
//     lunzi.write(0);     
//     run(1, 0, 0);
//     delay(1000);
//     lunzi.write(90);
//     run(2, 100, 80);
//     delay(1700);
//     run(1, 0, 0);
//     delay(1000);
//     lunzi.write(0);
//     run(3, 80, 120);
//     delay(1000);
//   }
}
